ryanstrat/apiary-card-reader/hardware/card.brd

## EAGLE design hardware/card.brd (2017-11-16)

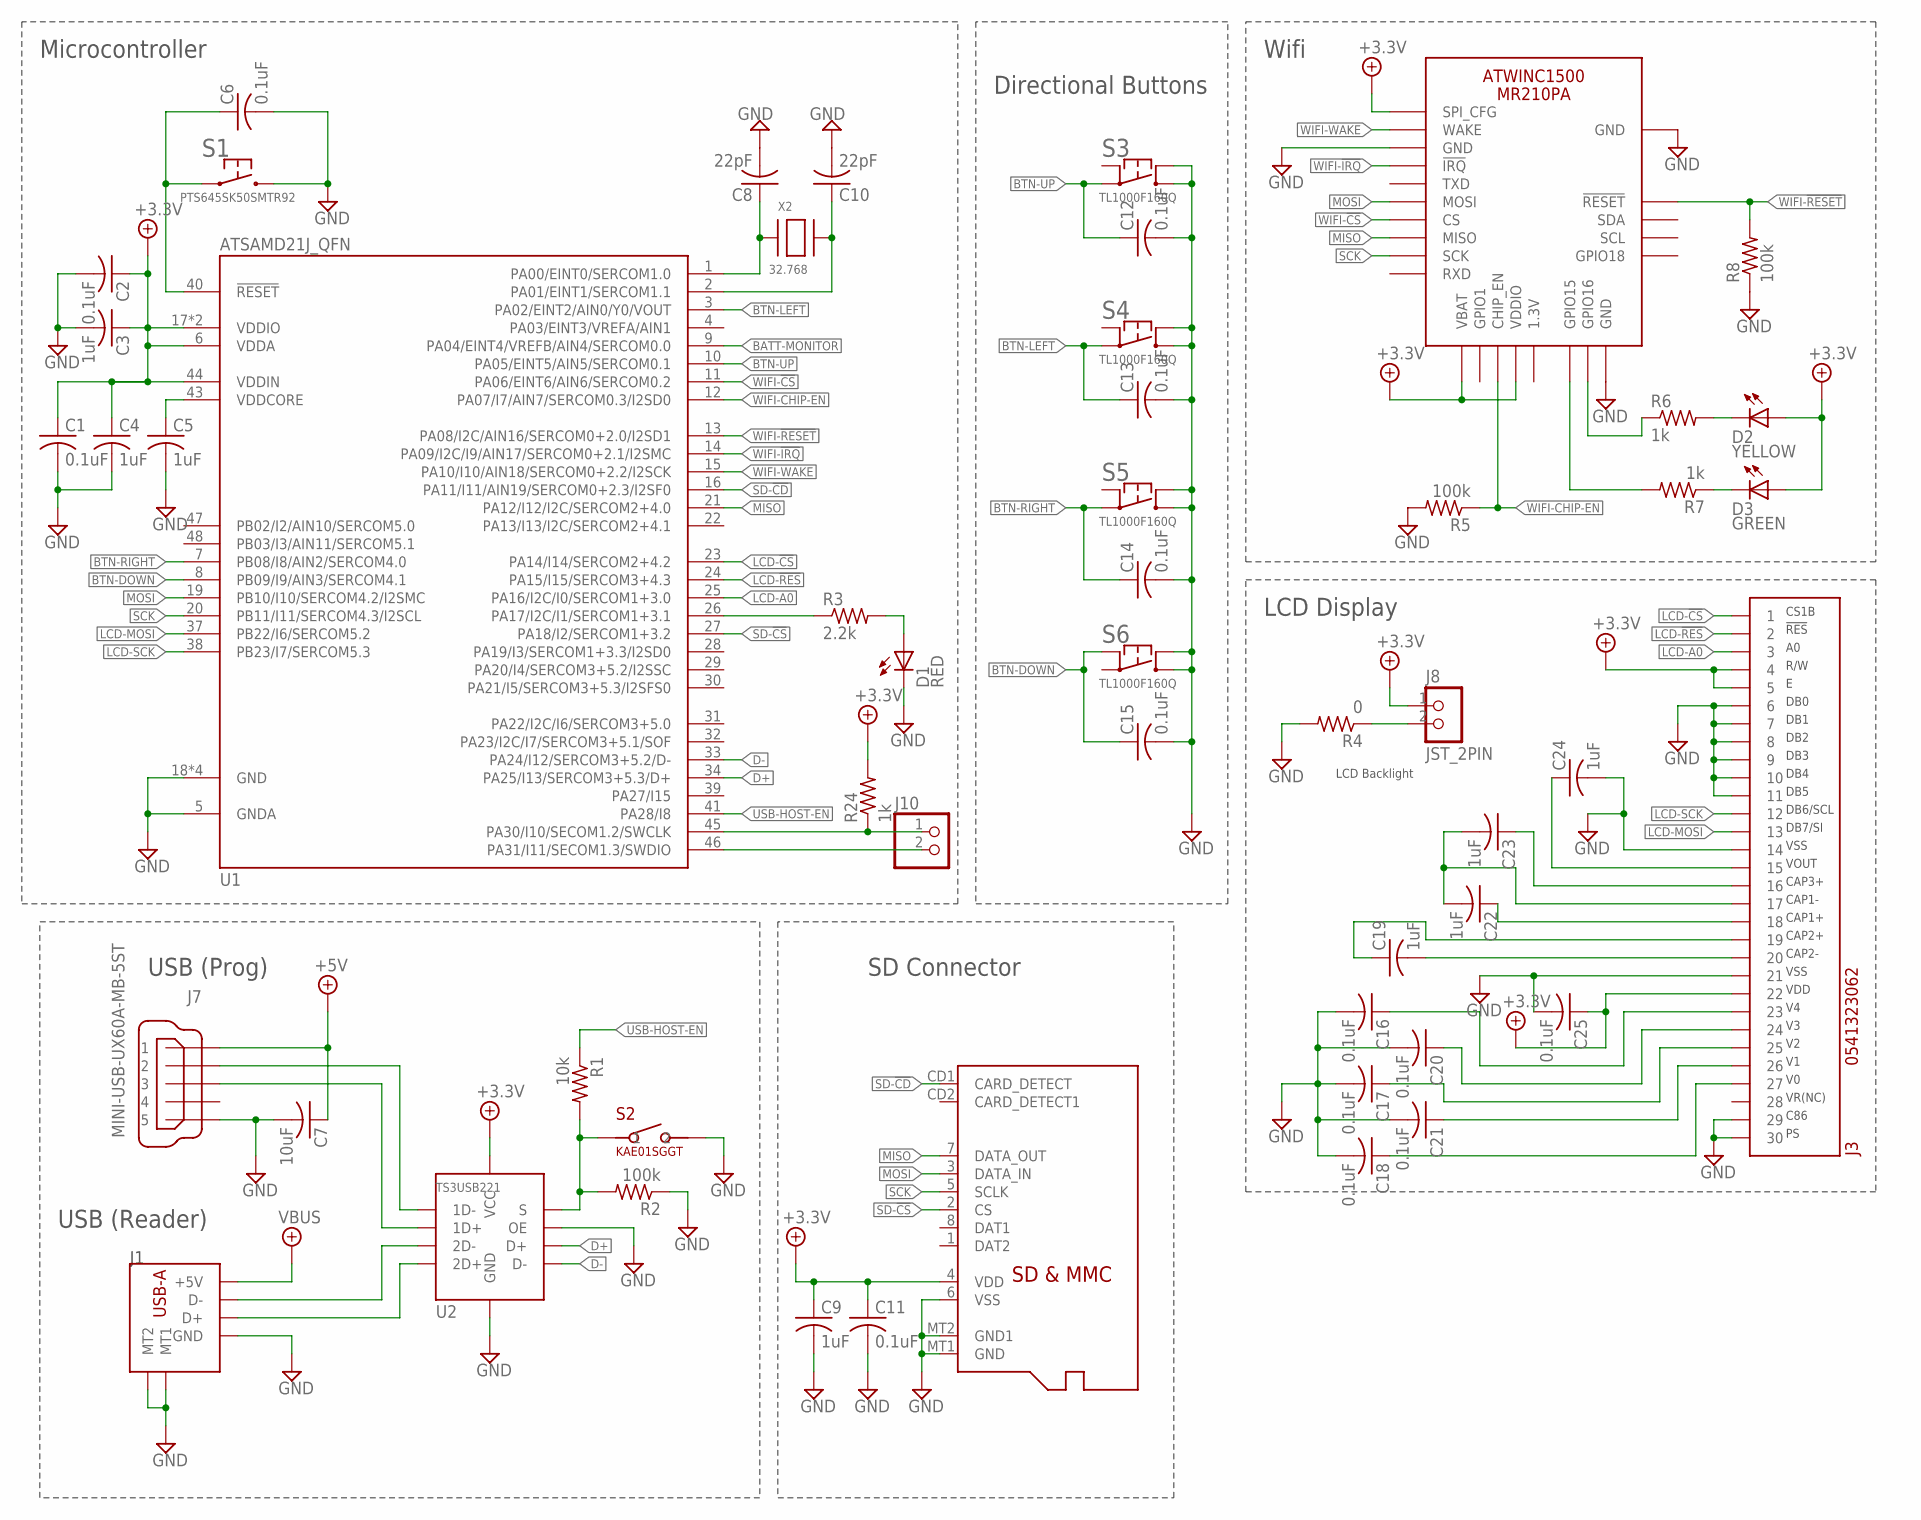
[picture p1: schematic card.sch, sheet 1, Logic]

Parts:
C1, C2, C6, C11, C12, C13, C14, C15, C16, C17, C18, C20, C21, C25: 0.1uF; C0603
C3, C4, C5, C9, C19, C22, C23, C24: 1uF; C0603
C7: 10uF; C0603
C8, C10: 22pF; C0603
D1: RED; CHIP-LED0603
D2: YELLOW; CHIP-LED0603
D3: GREEN; CHIP-LED0603
J1: UE27AC54100; USB-A
J2: MICROSD
J3: 0541323062
J7: MINI-USB-UX60A-MB-5ST; UX60A-MB-5ST
J8: JST_2PIN; JSTPH2
J10: CONN-2VERT; 1X2
R1: 10k; R0603
R2, R5, R8: 100k; R0603
R3: 2.2k; R0603
R4: 0; R0603
R6, R7, R24: 1k; R0603
S1: PTS645SK50SMTR92
S2: KAE01SGGT
S3, S4, S5, S6: TL1000F160Q; TL1100
U1: ATSAMD21J_QFN; TQFN48_7MM
U2: TS3USB221; 10-PIN-UQFN
X2: 32.768; XTAL3215
X3: ATWINC1500_MR210PA

Connections:
1D+: J7.3, U2.1 (1D+)
1D-: J7.2, U2.2 (1D-)
2D+: J1.3 (D+), U2.3 (2D+)
2D-: J1.2 (D-), U2.4 (2D-)
!RESET: C6.1, S1.1, S1.2 (1), U1.40 (!RESET)
+3.3V: C1.1, C2.1, C3.1, C4.1, C9.1, C11.1, C25.1, D2.A, D3.A, J2.4 (VDD), J3.4, J3.5, J3.22, J8.1, R24.2, U1.6 (VDDA), U1.17 (VDDIO), U1.36 (VDDIO), U1.44 (VDDIN), U2.10 (VCC), X3.J10 (SPI_CFG), X3.J20 (VBAT), X3.J23 (VDDIO); also elsewhere on the board
+5V: C7.1, J7.1; also elsewhere on the board
BATT-MONITOR: U1.9 (PA04/EINT4/VREFB/AIN4/SERCOM0.0); also elsewhere on the board
BTN-DOWN: C15.1, S6.2 (1B), U1.8 (PB09/I9/AIN3/SERCOM4.1)
BTN-LEFT: C13.1, S4.1 (1A), U1.3 (PA02/EINT2/AIN0/Y0/VOUT)
BTN-RIGHT: C14.1, S5.1 (1A), U1.7 (PB08/I8/AIN2/SERCOM4.0)
BTN-UP: C12.1, S3.1 (1A), U1.10 (PA05/EINT5/AIN5/SERCOM0.1)
D+: U1.34 (PA25/I13/SERCOM3+5.3/D+), U2.8 (D+)
D-: U1.33 (PA24/I12/SERCOM3+5.2/D-), U2.7 (D-)
GND: C1.2, C2.2, C3.2, C4.2, C5.2, C6.2, C7.2, C8.2, C9.2, C10.2, C11.2, C12.2, C13.2, C14.2, C15.2, C16.2, C17.2, C18.2, C20.2, C21.2, C24.2, C25.2, D1.C (K), J1.4 (GND), J1.MT1, J1.MT2, J2.6 (VSS), J2.MT1 (GND), J2.MT2 (GND1), J3.6, J3.7, J3.8, J3.9, J3.10, J3.11, J3.14, J3.21, J3.29, J3.30, J7.5, R2.1, R4.2, R5.2, R8.1, S1.3 (2), S1.4 (2), S2.2, S3.3 (2A), S3.4 (2B), S4.3 (2A), S4.4 (2B), S5.3 (2A), S5.4 (2B), S6.3 (2A), S6.4 (2B), U1.5 (GNDA), U1.18 (GND), U1.35 (GND), U1.42 (GND), U1.THERMAL (GND), U2.5 (GND), U2.6 (OE), X3.J9 (GND), X3.J12 (GND), X3.J28 (GND); also elsewhere on the board
LCD-!CS: J3.1, U1.23 (PA14/I14/SERCOM2+4.2)
LCD-!RES: J3.2, U1.24 (PA15/I15/SERCOM3+4.3)
LCD-A0: J3.3, U1.25 (PA16/I2C/I0/SERCOM1+3.0)
LCD-CA1+: C22.1, J3.18
LCD-CA1-: C22.2, C23.2, J3.17
LCD-CA2+: C19.1, J3.19
LCD-CA2-: C19.2, J3.20
LCD-CA3+: C23.1, J3.16
LCD-K: J8.2, R4.1
LCD-MOSI: J3.13, U1.37 (PB22/I6/SERCOM5.2)
LCD-SCK: J3.12, U1.38 (PB23/I7/SERCOM5.3)
LCD-V0: C18.1, J3.27
LCD-V1: C21.1, J3.26
LCD-V2: C17.1, J3.25
LCD-V3: C20.1, J3.24
LCD-V4: C16.1, J3.23
LCD-VOUT: C24.1, J3.15
MISO: J2.7 (DATA_OUT), U1.21 (PA12/I12/I2C/SERCOM2+4.0), X3.J17 (MISO)
MOSI: J2.3 (DATA_IN), U1.19 (PB10/I10/SERCOM4.2/I2SMC), X3.J15 (MOSI)
PROG-LED: D1.A, R3.2
PROG-LED-2: R3.1, U1.26 (PA17/I2C/I1/SERCOM1+3.1)
SCK: J2.5 (SCLK), U1.20 (PB11/I11/SERCOM4.3/I2SCL), X3.J18 (SCK)
SD-!CD: J2.CD1 (CARD_DETECT), U1.16 (PA11/I11/AIN19/SERCOM0+2.3/I2SF0)
SD-!CS: J2.2 (CS), U1.27 (PA18/I2/SERCOM1+3.2)
SWCLK: J10.1, R24.1, U1.45 (PA30/I10/SECOM1.2/SWCLK)
SWDIO: J10.2, U1.46 (PA31/I11/SECOM1.3/SWDIO)
USB-HOST-EN: R1.1, U1.41 (PA28/I8)
USB-S: R1.2, R2.2, S2.1, U2.9 (S)
VBUS: J1.1 (+5V); also elsewhere on the board
VDDCORE: C5.1, U1.43 (VDDCORE)
WIFI-!CS: U1.11 (PA06/EINT6/AIN6/SERCOM0.2), X3.J16 (CS)
WIFI-!IRQ: U1.14 (PA09/I2C/I9/AIN17/SERCOM0+2.1/I2SMC), X3.J13 (!IRQ)
WIFI-!RESET: R8.2, U1.13 (PA08/I2C/AIN16/SERCOM0+2.0/I2SD1), X3.J4 (!RESET)
WIFI-CHIP-EN: R5.1, U1.12 (PA07/I7/AIN7/SERCOM0.3/I2SD0), X3.J22 (CHIP_EN)
WIFI-GPIO15: R7.2, X3.J26 (GPIO15)
WIFI-GPIO16: R6.1, X3.J27 (GPIO16)
WIFI-LED-G: D3.C (K), R7.1
WIFI-LED-Y: D2.C (K), R6.2
WIFI-WAKE: U1.15 (PA10/I10/AIN18/SERCOM0+2.2/I2SCK), X3.J11 (WAKE)
X3-1: C8.1, U1.1 (PA00/EINT0/SERCOM1.0), X2.P$1
X3-2: C10.1, U1.2 (PA01/EINT1/SERCOM1.1), X2.P$2

Notes on the sheet:
Microcontroller
USB (Prog)
SD Connector
USB (Reader)
Wifi
Directional Buttons
CS1B
!RES
R/W
DB0
DB1
DB2
DB3
DB4
DB5
DB6/SCL
DB7/SI
VSS
VOUT
CAP3+
CAP1-
CAP1+
CAP2+
CAP2-
VDD
VR(NC)
C86
LCD Display
LCD Backlight

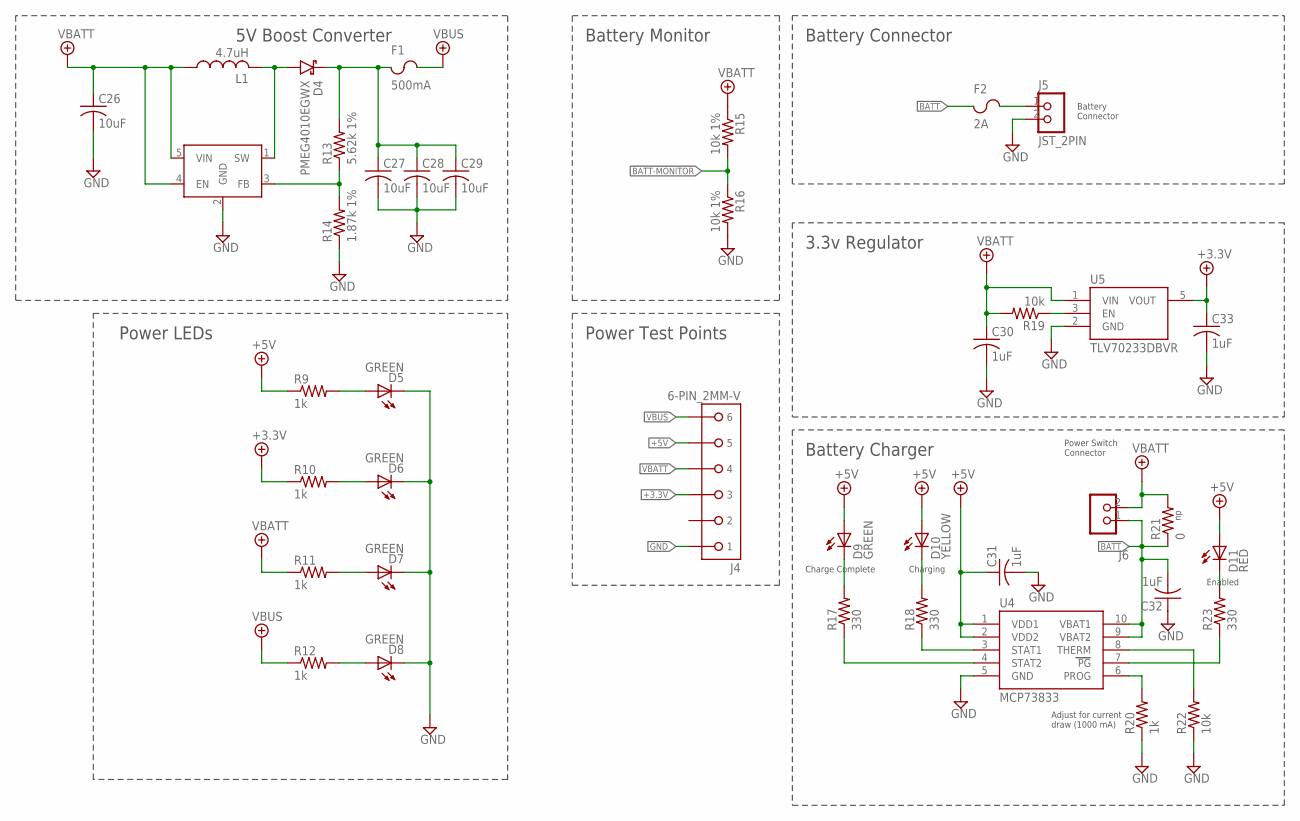
[picture p2: schematic card.sch, sheet 2, Power]

Parts:
C26, C27, C28, C29: 10uF; C0603
C30, C31, C32, C33: 1uF; C0603
D4: PMEG4010EGWX; SOD123
D5, D6, D7, D8, D9: GREEN; CHIP-LED0603
D10: YELLOW; CHIP-LED0603
D11: RED; CHIP-LED0603
F1: 500mA; F0603
F2: 2A; F0603
J4: 6-PIN_2MM-V; 2MM-6-V
J5, J6: JST_2PIN; JSTPH2
L1: 4.7uH; L0805
R9, R10, R11, R12, R20: 1k; R0603
R13: 5.62k 1%; R0603
R14: 1.87k 1%; R0603
R15, R16: 10k 1%; R0603
R17, R18, R23: 330; R0603
R19, R22: 10k; R0603
R21: 0; R0603
U3: MIC2288YD5-TR; TSOT-23-5
U4: MCP73833; MSOP10
U5: TLV70233DBVR; SOT-23-5

Connections:
3V3_EN: R19.1, U5.3 (EN)
+3.3V: C33.1, J4.3, R10.1, U5.5 (VOUT); also elsewhere on the board
+5V: C31.1, D9.A, D10.A, D11.A, J4.5, R9.1, U4.1 (VDD1), U4.2 (VDD2); also elsewhere on the board
BATT: C32.2, F2.1, J6.1, R21.1, U4.9 (VBAT2), U4.10 (VBAT1)
BATT-MONITOR: R15.2, R16.1; also elsewhere on the board
BATT-PRE-FUSE: F2.2, J5.1
BOOST_FB: R13.1, R14.2, U3.3 (FB)
BOOST_OUTPUT: C27.1, C28.1, C29.1, D4.C, F1.1, R13.2
BOOST_SW: D4.A, L1.2, U3.1 (SW)
CHRG-!PG: R23.1, U4.7 (PG)
CHRG-PROG: R20.2, U4.6 (PROG)
CHRG-STAT1: R18.1, U4.3 (STAT1)
CHRG-STAT2: R17.1, U4.4 (STAT2)
CHRG-THERM: R22.2, U4.8 (THERM)
GND: C26.2, C27.2, C28.2, C29.2, C30.2, C31.2, C32.1, C33.2, D5.C (K), D6.C (K), D7.C (K), D8.C (K), J4.1, J5.2, R14.1, R16.2, R20.1, R22.1, U3.2 (GND), U4.5 (GND), U5.2 (GND); also elsewhere on the board
LED-3V3: D6.A, R10.2
LED-5V: D8.A, R12.2
LED-!PG: D11.C (K), R23.2
LED-STAT1: D10.C (K), R18.2
LED-STAT2: D9.C (K), R17.2
LED-VBATT: D7.A, R11.2
LED-VBUS: D5.A, R9.2
VBATT: C26.1, C30.1, J4.4, J6.2, L1.1, R11.1, R15.1, R19.2, R21.2, U3.4 (EN), U3.5 (VIN), U5.1 (VIN)
VBUS: F1.2, J4.6, R12.1; also elsewhere on the board

Notes on the sheet:
Adjust for current draw (1000 mA)
Battery Connector
Battery Connector
3.3v Regulator
Battery Charger
Battery Monitor
Power Switch Connector
5V Boost Converter
Power Test Points
Charge Complete
Charging
Enabled
Power LEDs

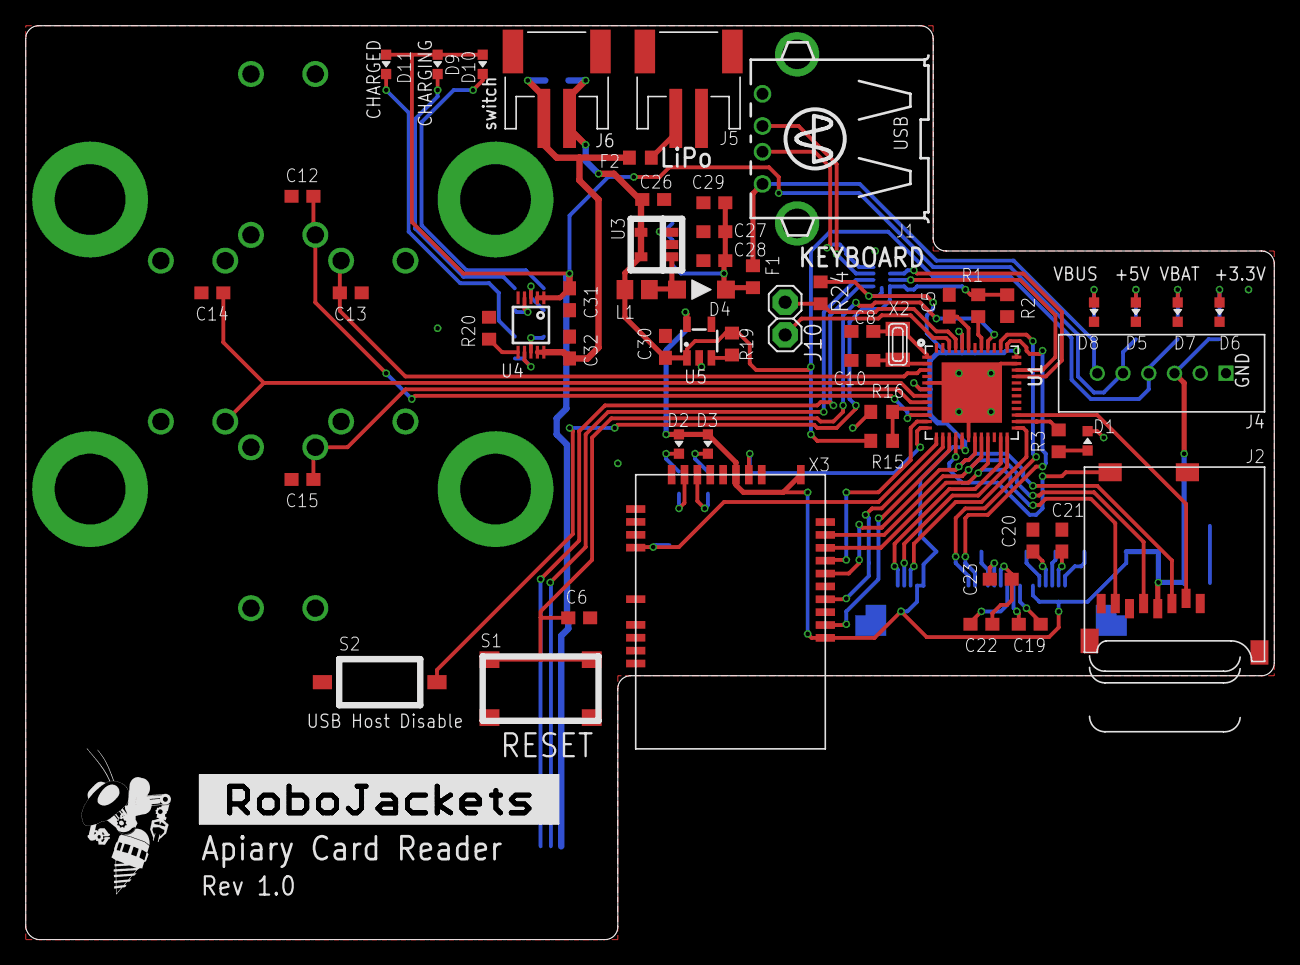
[picture p3: board hardware/card.brd from above]

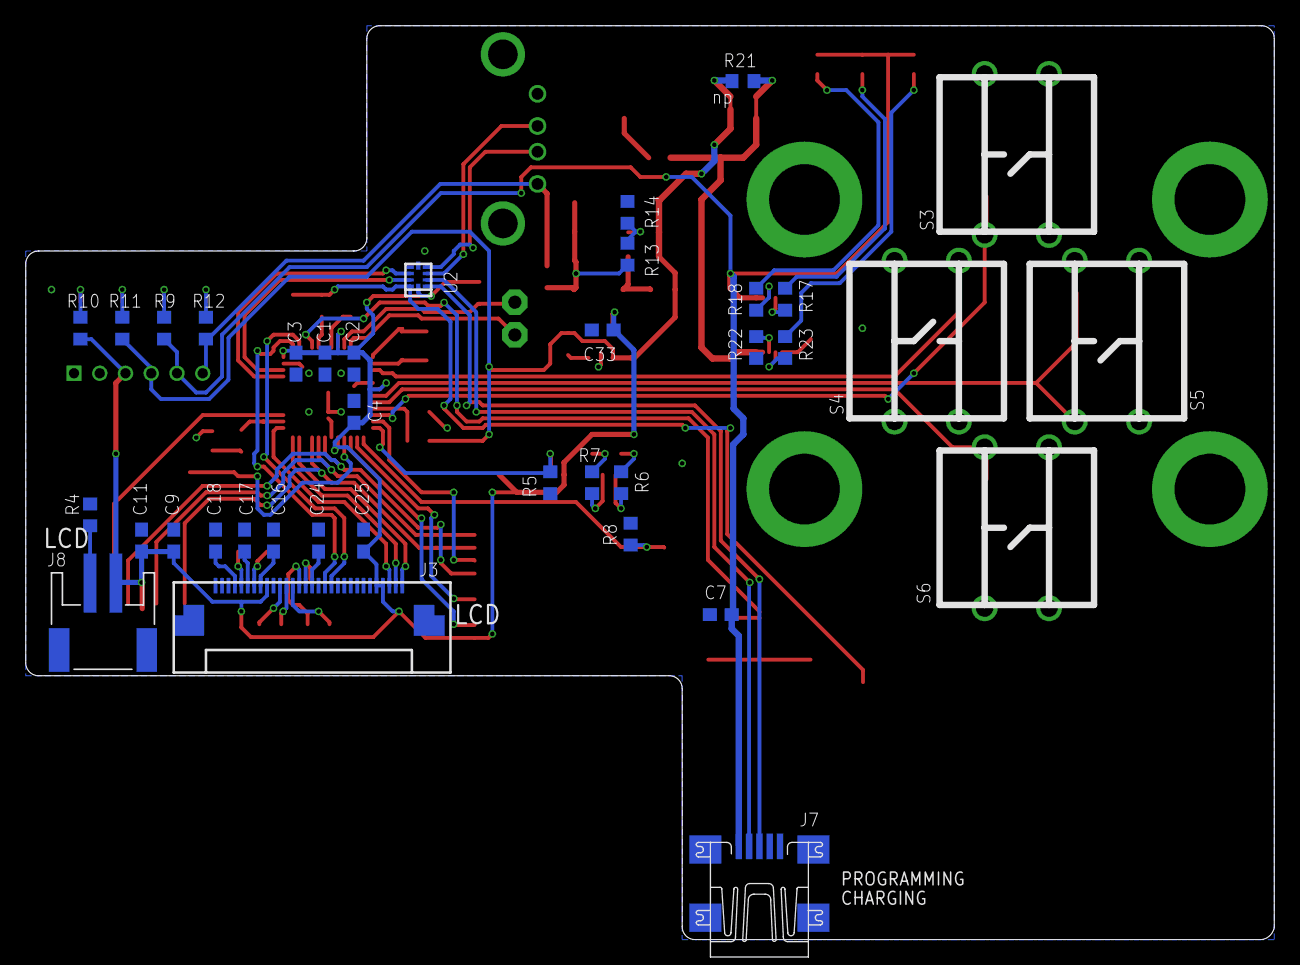
[picture p4: board hardware/card.brd from below]

Board: 2 copper layers, 97.0 x 71.0 mm, 95 parts (37 on the bottom side), 75 nets.

Other parts of the board:
U$1: ROBOBUZZ_0.6X
U$2: ROBOJACKETS
