ryanstrat/apiary-card-reader/card.brd

## EAGLE design card.brd (2017-11-09)

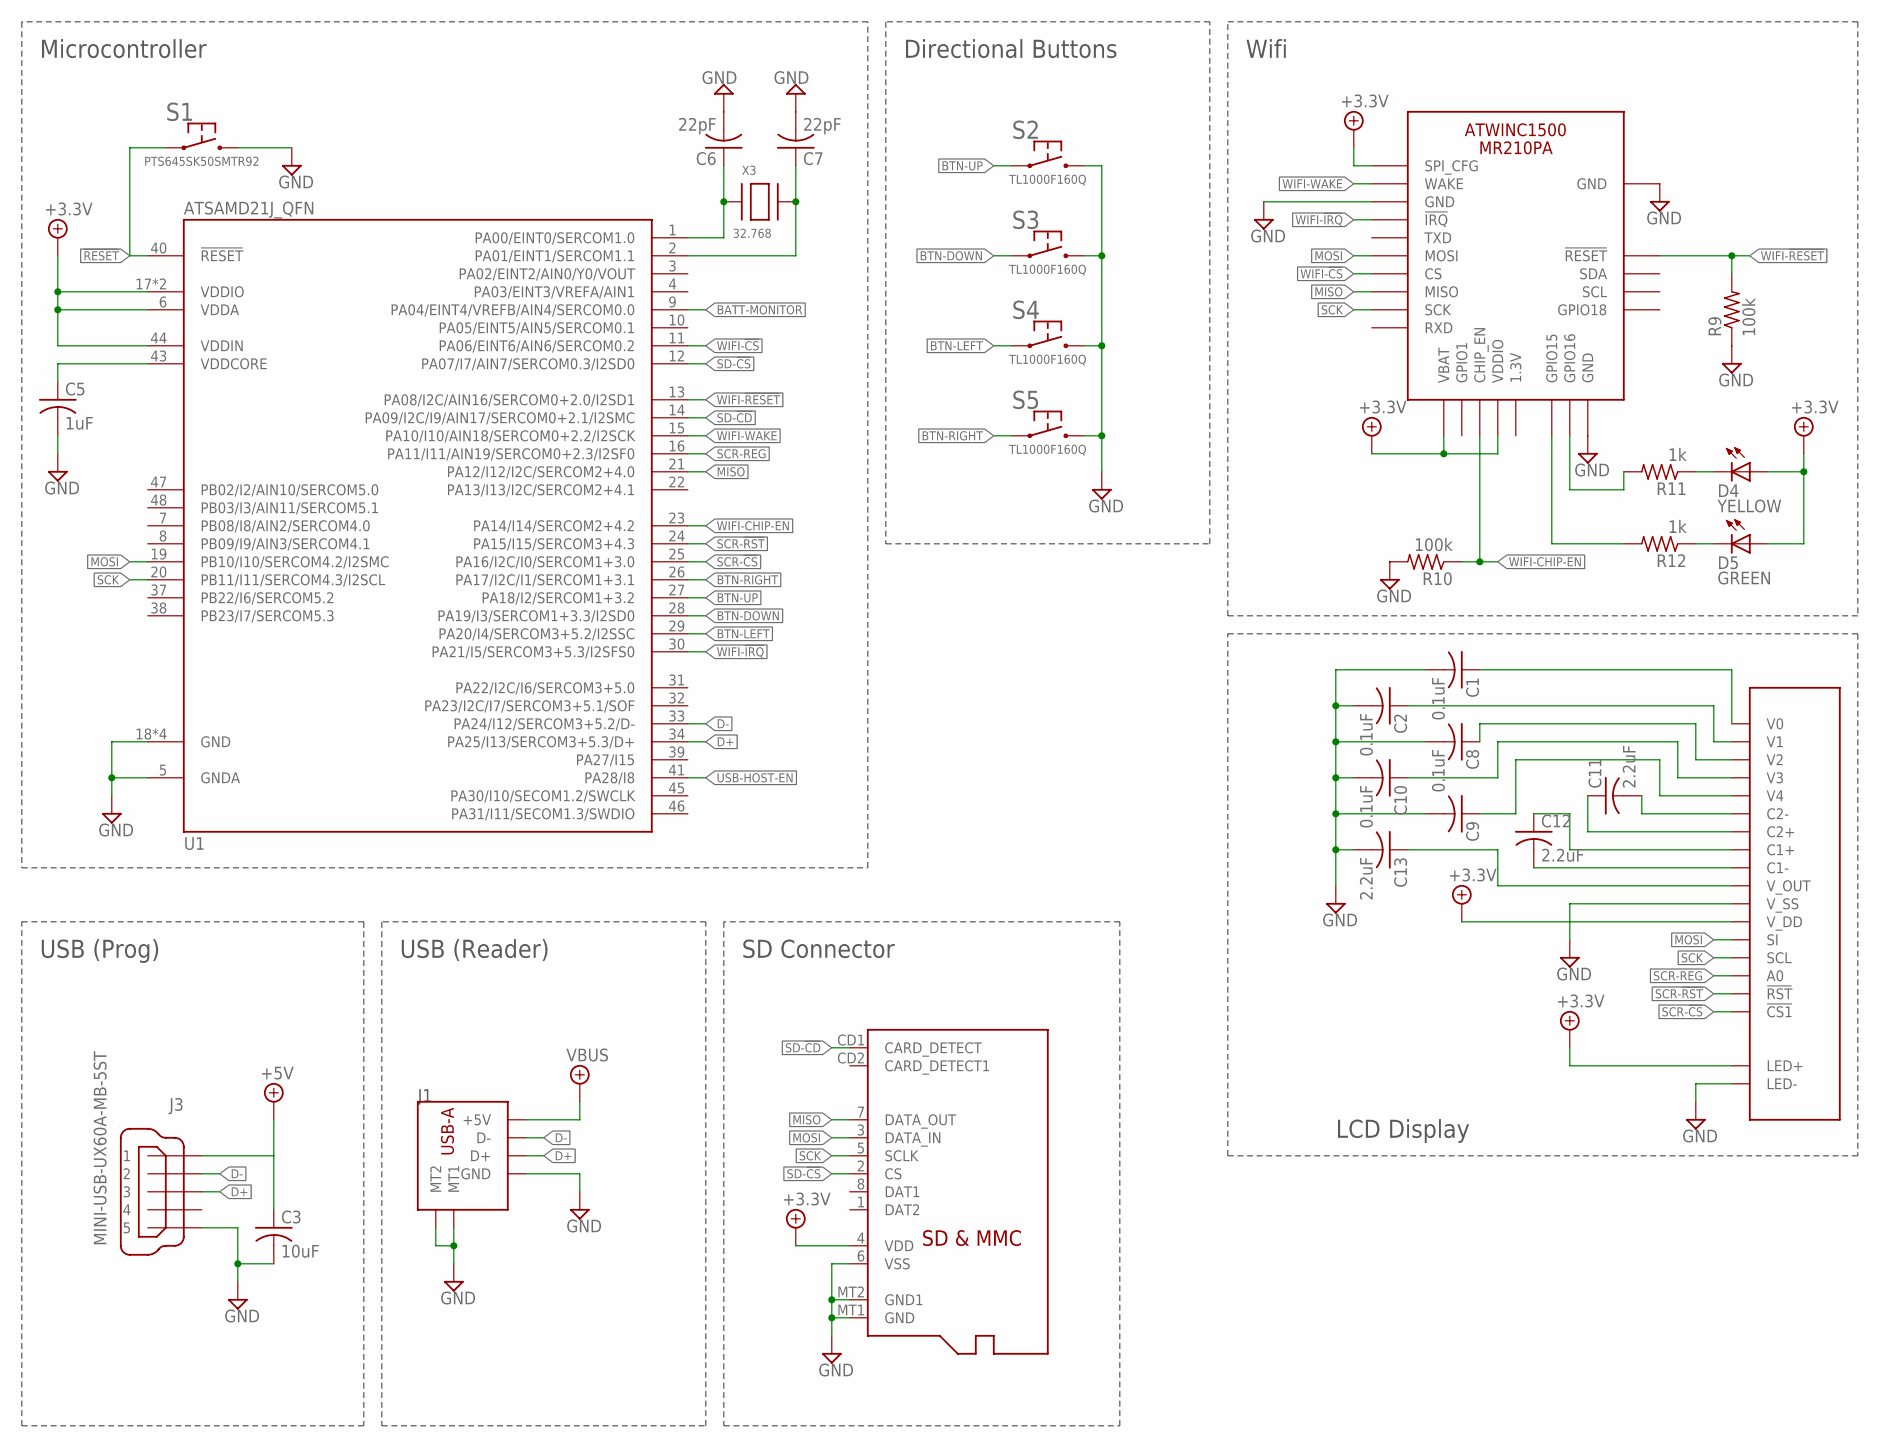
[picture p5: schematic card.sch, sheet 1]

Parts:
C1, C2, C8, C10: 0.1uF; C0603
C3: 10uF; C0805
C5: 1uF; C0603
C6, C7: 22pF; C0603
C9: C-USC0603; C0603
C11, C12, C13: 2.2uF; C0603
D4: YELLOW; SMARTLED-TTW
D5: GREEN; SMARTLED-TTW
J1: UE27AC54100; USB-A
J3: MINI-USB-UX60A-MB-5ST; UX60A-MB-5ST
J4: MICROSD
R9, R10: 100k; R0603W
R11, R12: 1k; R0603W
S1: PTS645SK50SMTR92
S2, S3, S4, S5: TL1000F160Q; TL1100
U1: ATSAMD21J_QFN; TQFN48_7MM
U4: ATWINC1500_MR210PA
U5: NHD-C12832A1Z-FSW-FBW-3V3
X3: 32.768; XTAL3215

Connections:
!RESET: S1.1, S1.2 (1), U1.40 (!RESET)
+3.3V: D4.A@1 (A), D5.A@1 (A), J4.4 (VDD), U1.6 (VDDA), U1.17 (VDDIO), U1.36 (VDDIO), U1.44 (VDDIN), U4.J10 (SPI_CFG), U4.J20 (VBAT), U4.J23 (VDDIO), U5.LED+, U5.V_DD; also elsewhere on the board
BATT-MONITOR: U1.9 (PA04/EINT4/VREFB/AIN4/SERCOM0.0); also elsewhere on the board
BTN-DOWN: S3.1, S3.2 (1), U1.28 (PA19/I3/SERCOM1+3.3/I2SD0)
BTN-LEFT: S4.1, S4.2 (1), U1.29 (PA20/I4/SERCOM3+5.2/I2SSC)
BTN-RIGHT: S5.1, S5.2 (1), U1.26 (PA17/I2C/I1/SERCOM1+3.1)
BTN-UP: S2.1, S2.2 (1), U1.27 (PA18/I2/SERCOM1+3.2)
D+: J1.3 (D+), J3.3, U1.34 (PA25/I13/SERCOM3+5.3/D+)
D-: J1.2 (D-), J3.2, U1.33 (PA24/I12/SERCOM3+5.2/D-)
GND: C1.2, C2.2, C3.2, C5.2, C6.2, C7.2, C8.2, C9.2, C10.2, C13.2, J1.4 (GND), J1.MT1, J1.MT2, J3.5, J4.6 (VSS), J4.MT1 (GND), J4.MT2 (GND1), R9.1 (PIN1), R10.2 (PIN2), S1.3 (2), S1.4 (2), S2.3 (2), S2.4 (2), S3.3 (2), S3.4 (2), S4.3 (2), S4.4 (2), S5.3 (2), S5.4 (2), U1.5 (GNDA), U1.18 (GND), U1.35 (GND), U1.42 (GND), U1.THERMAL (GND), U4.J9 (GND), U4.J12 (GND), U4.J28 (GND), U5.LED-, U5.V_SS; also elsewhere on the board
MISO: J4.7 (DATA_OUT), U1.21 (PA12/I12/I2C/SERCOM2+4.0), U4.J17 (MISO)
MOSI: J4.3 (DATA_IN), U1.19 (PB10/I10/SERCOM4.2/I2SMC), U4.J15 (MOSI), U5.SI
unnamed: R11.2 (PIN2), U4.J27 (GPIO16)
unnamed: R12.2 (PIN2), U4.J26 (GPIO15)
unnamed: C5.1, U1.43 (VDDCORE)
unnamed: C6.1, U1.1 (PA00/EINT0/SERCOM1.0), X3.P$1
unnamed: C7.1, U1.2 (PA01/EINT1/SERCOM1.1), X3.P$2
unnamed: D4.C@1 (C), R11.1 (PIN1)
unnamed: D5.C@1 (C), R12.1 (PIN1)
unnamed: C1.1, U5.V0
unnamed: C8.1, U5.V2
unnamed: C10.1, U5.V3
unnamed: C2.1, U5.V1
unnamed: C9.1, U5.V4
unnamed: C11.1, U5.C2+
unnamed: C11.2, U5.C2-
unnamed: C13.1, U5.V_OUT
unnamed: C12.2, U5.C1-
unnamed: C3.1, J3.1
SCK: J4.5 (SCLK), U1.20 (PB11/I11/SERCOM4.3/I2SCL), U4.J18 (SCK), U5.SCL
SCR-!CS: U1.25 (PA16/I2C/I0/SERCOM1+3.0), U5.!CS1
SCR-!RST: U1.24 (PA15/I15/SERCOM3+4.3), U5.!RST
SCR-REG: U1.16 (PA11/I11/AIN19/SERCOM0+2.3/I2SF0), U5.A0
SD-!CD: J4.CD1 (CARD_DETECT), U1.14 (PA09/I2C/I9/AIN17/SERCOM0+2.1/I2SMC)
SD-!CS: J4.2 (CS), U1.12 (PA07/I7/AIN7/SERCOM0.3/I2SD0)
USB-HOST-EN: U1.41 (PA28/I8)
VBUS: J1.1 (+5V); also elsewhere on the board
WIFI-!CS: U1.11 (PA06/EINT6/AIN6/SERCOM0.2), U4.J16 (CS)
WIFI-!IRQ: U1.30 (PA21/I5/SERCOM3+5.3/I2SFS0), U4.J13 (!IRQ)
WIFI-!RESET: R9.2 (PIN2), U1.13 (PA08/I2C/AIN16/SERCOM0+2.0/I2SD1), U4.J4 (!RESET)
WIFI-CHIP-EN: R10.1 (PIN1), U1.23 (PA14/I14/SERCOM2+4.2), U4.J22 (CHIP_EN)
WIFI-WAKE: U1.15 (PA10/I10/AIN18/SERCOM0+2.2/I2SCK), U4.J11 (WAKE)

Notes on the sheet:
Microcontroller
USB (Prog)
SD Connector
USB (Reader)
LCD Display
Wifi
Directional Buttons

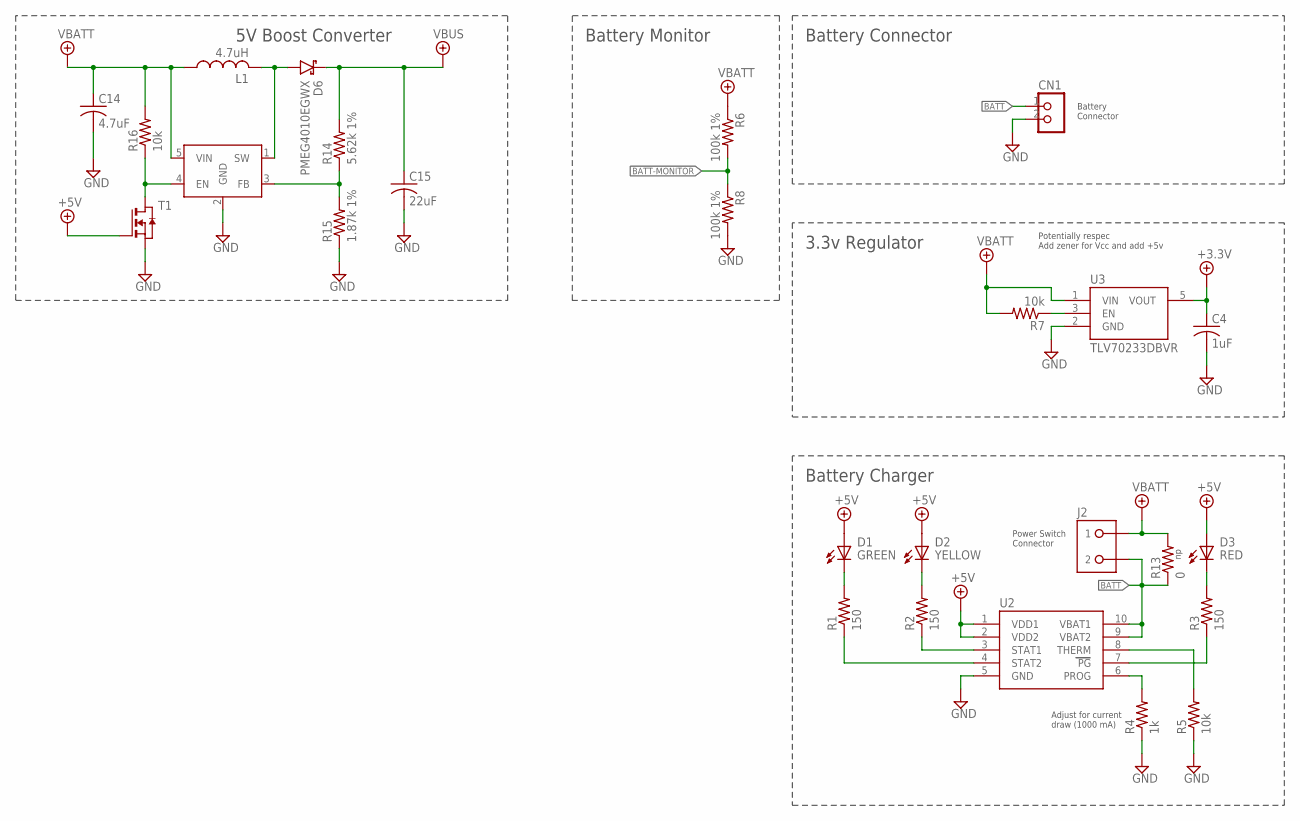
[picture p6: schematic card.sch, sheet 2, Power]

Parts:
C4: 1uF; C0603
C14: 4.7uF; C0603
C15: 22uF; C0603
CN1: JST_2PIN; JSTPH2
D1: GREEN; CHIP-LED0603
D2: YELLOW; CHIP-LED0603
D3: RED; CHIP-LED0603
D6: PMEG4010EGWX; SOD123
J2: B2PS-VH(LF)(SN); B2PS-CENTERED
L1: 4.7uH; L0805
R1, R2, R3: 150; R0603
R4: 1k; R0603
R5, R7, R16: 10k; R0603
R6, R8: 100k 1%; R0603
R13: 0; R0603
R14: 5.62k 1%; R0603
R15: 1.87k 1%; R0603
T1: BSS138; SOT-23
U2: MCP73833; MSOP10
U3: TLV70233DBVR; SOT-23-5
U6: MIC2288YD5-TR; TSOT-23-5

Connections:
3V3_EN: R7.1, U3.3 (EN)
+3.3V: C4.1, U3.5 (VOUT); also elsewhere on the board
+5V: D1.A, D2.A, D3.A, T1.3 (G), U2.1 (VDD1), U2.2 (VDD2)
BATT: CN1.1, J2.2, R13.1, U2.9 (VBAT2), U2.10 (VBAT1)
BATT-MONITOR: R6.2, R8.1; also elsewhere on the board
BOOST_ENABLE: R16.1, T1.1 (D), U6.4 (EN)
BOOST_FB: R14.1, R15.2, U6.3 (FB)
BOOST_SW: D6.A, L1.2, U6.1 (SW)
GND: C4.2, C14.2, C15.2, CN1.2, R4.1, R5.1, R8.2, R15.1, T1.2 (S), U2.5 (GND), U3.2 (GND), U6.2 (GND); also elsewhere on the board
unnamed: D1.C (K), R1.2
unnamed: D2.C (K), R2.2
unnamed: R2.1, U2.3 (STAT1)
unnamed: R1.1, U2.4 (STAT2)
unnamed: R3.1, U2.7 (PG)
unnamed: D3.C (K), R3.2
unnamed: R4.2, U2.6 (PROG)
unnamed: R5.2, U2.8 (THERM)
VBATT: C14.1, J2.1, L1.1, R6.1, R7.2, R13.2, R16.2, U3.1 (VIN), U6.5 (VIN)
VBUS: C15.1, D6.C, R14.2; also elsewhere on the board

Notes on the sheet:
Adjust for current draw (1000 mA)
Battery Connector
Battery Connector
3.3v Regulator
Battery Charger
Potentially respec Add zener for Vcc and add +5v
Battery Monitor
Power Switch Connector
5V Boost Converter

Board: 2 copper layers, 56 parts (0 on the bottom side), 56 nets, no tracks yet.
