ryanstrat/apiary-card-reader/(commit log)

2017-11-09 Add directional buttons, conect pins to MCU, delete scr file
    [card.brd, card.sch]
2017-11-10 add framing for software components. Design review schematic tweaks
    [card.brd, card.sch]
2017-11-14 Schematic Finished
    [card.brd, card.sch]
2017-11-14 Added power test points and LEDs
    [card.brd, card.sch]
2017-11-14 halfway through routing
    [card.brd, card.sch]
2017-11-15 basically done routing attempt 1
    [card.brd, card.sch]
2017-11-15 board routing attempt 2
    [card.brd, card.sch]
2017-11-15 silkscreen additions, fixed button labels
    [card.brd, card.sch]
2017-11-15 More tweaks, fix DRC error
    [card.brd, card.sch]
2017-11-15 Increase board size to put USB-B port at the edge of the case
    [card.brd]
2017-11-15 label U2
    [card.brd]
2017-11-15 fix a cap with the wrong footprint
    [apiary-card-reader-bom.csv, card.brd, card.sch]
2017-11-16 exported gerbers
    swapped the power switch connector
    [card.brd, card.sch]
2017-11-30 start of validation software, case designs
2017-12-04 fix positioning of display and mounting holes on case top and bottom
    [card.sch]
2017-12-05 Reads config file from sd for network settings and connects to wifi Reads buzzcards Sends gtids to Apiary (unsuccessfully)
    [main.cpp]
